isadora-fernanda/pigsave-esp8266/hardware/3d/tampa-com-dobradica/solidworks/Conjunto tampa.SLDASM

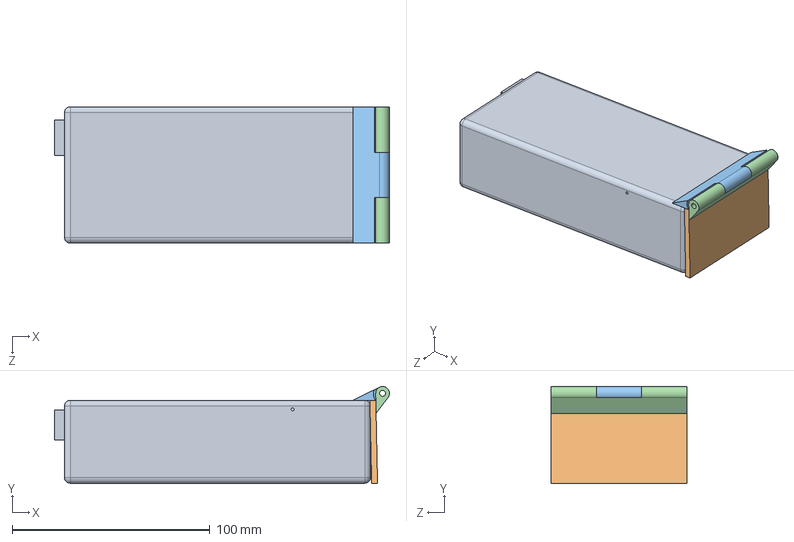
[picture p8: CAD file, 2026-10-20]
hardware/3d/tampa-com-dobradica/solidworks/Conjunto tampa.SLDASM
169.5 x 49.1 x 69.0 mm
Base cinta teste 2
LID
Hinge 1
Hinge 2
