isadora-fernanda/pigsave-esp8266/hardware/3d/involucro/solidworks/Conjunto REV03.SLDASM

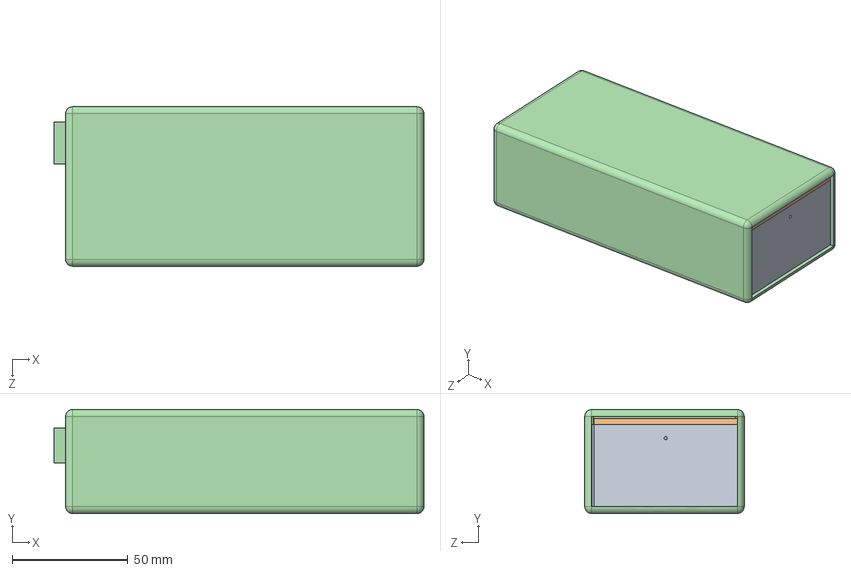
[picture p9: CAD file, 2026-10-20]
hardware/3d/involucro/solidworks/Conjunto REV03.SLDASM
160.0 x 45.0 x 69.0 mm
base bateria REV03
Tampa bateria REV03
Gaveta placa REV03
Base cinta REV03
