isadora-fernanda/pigsave-esp8266/hardware/3d/involucro/solidworks/Gaveta placa REV03.SLDPRT

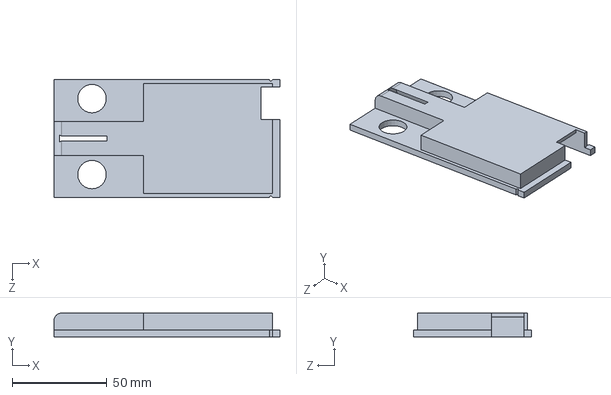
[picture p10: CAD file, 2026-10-20]
hardware/3d/involucro/solidworks/Gaveta placa REV03.SLDPRT
119.0 x 12.6 x 62.0 mm
