isadora-fernanda/pigsave-esp8266/hardware/3d/involucro/solidworks/Base cinta REV03.SLDPRT

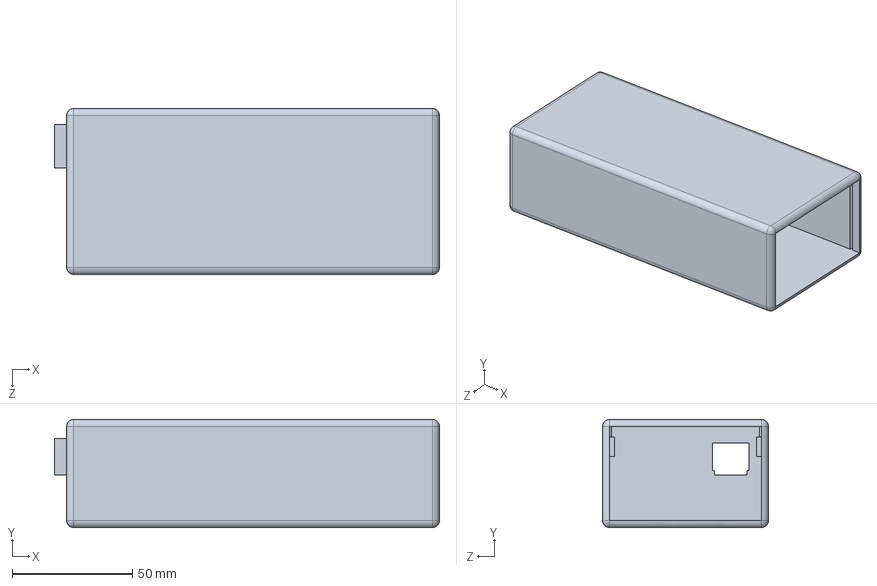
[picture p11: CAD file, 2026-10-20]
hardware/3d/involucro/solidworks/Base cinta REV03.SLDPRT
160.0 x 45.0 x 69.0 mm
