isadora-fernanda/pigsave-esp8266/hardware/3d/tampa-com-dobradica/solidworks/LID.SLDPRT

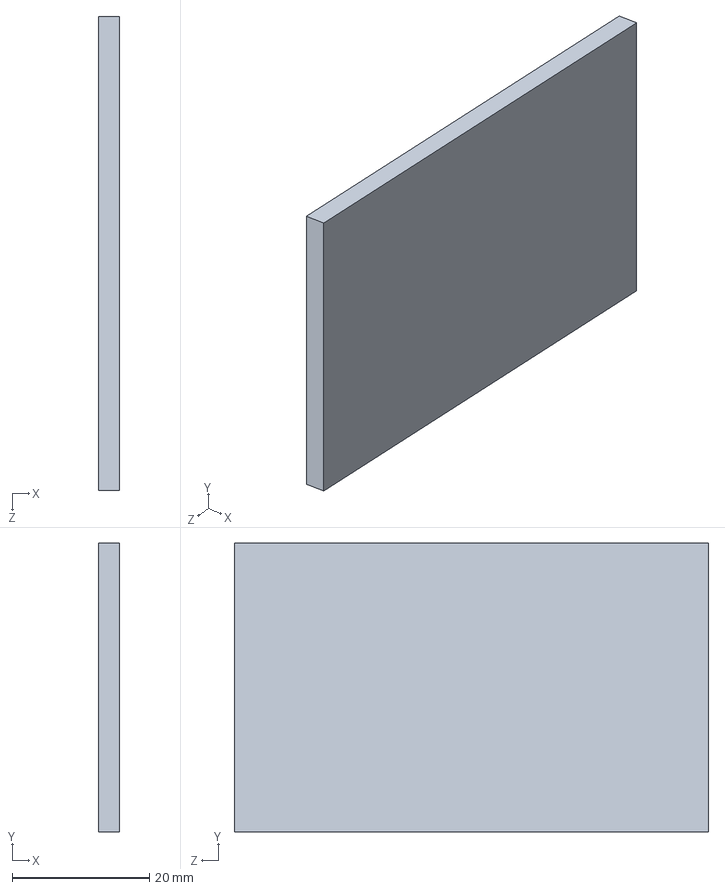
[picture p12: CAD file, 2026-10-20]
hardware/3d/tampa-com-dobradica/solidworks/LID.SLDPRT
3.00 x 42.0 x 69.0 mm
