isadora-fernanda/pigsave-esp8266/hardware/3d/involucro/solidworks/base bateria REV03.SLDPRT

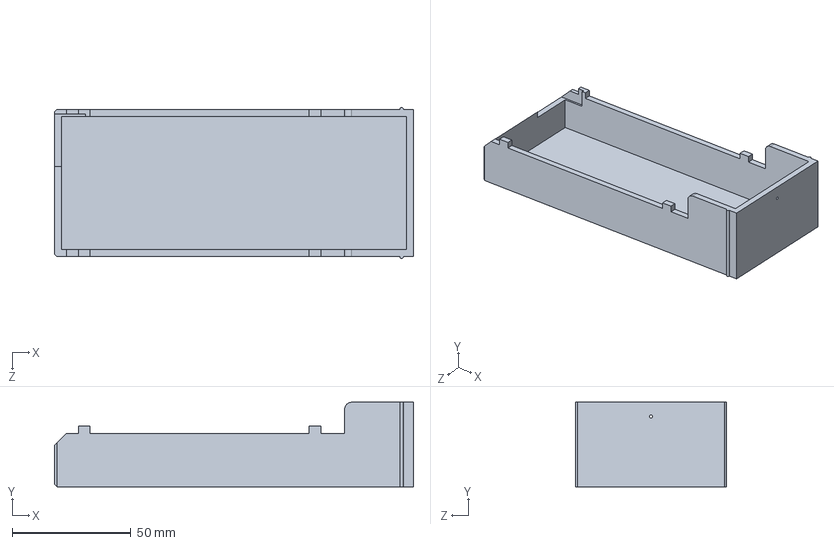
[picture p13: CAD file, 2026-10-20]
hardware/3d/involucro/solidworks/base bateria REV03.SLDPRT
151.0 x 35.6 x 63.5 mm
