isadora-fernanda/pigsave-esp8266/hardware/3d/tampa-com-dobradica/solidworks/Base cinta teste 2.SLDPRT

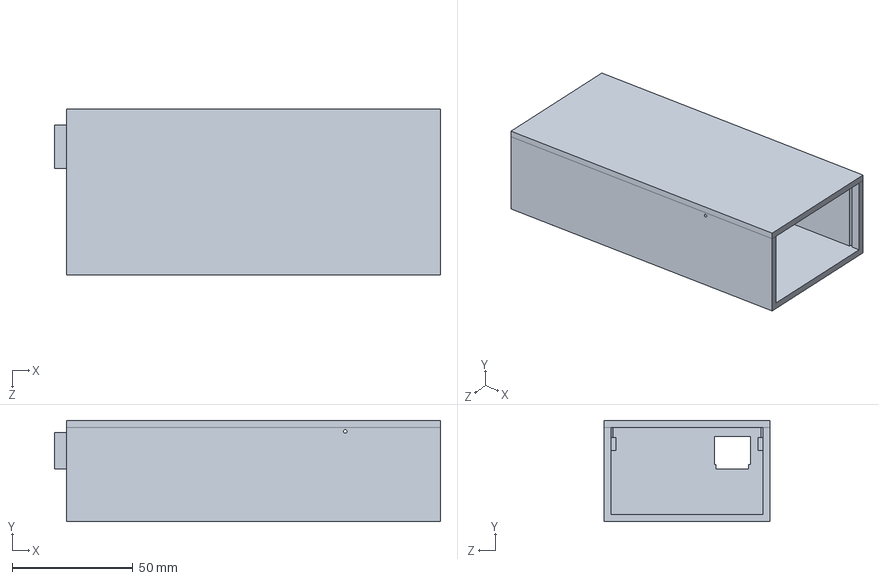
[picture p14: CAD file, 2026-10-20]
hardware/3d/tampa-com-dobradica/solidworks/Base cinta teste 2.SLDPRT
160.0 x 42.0 x 69.0 mm
