isadora-fernanda/pigsave-esp8266/hardware/3d/involucro/solidworks/Tampa bateria REV03.SLDPRT

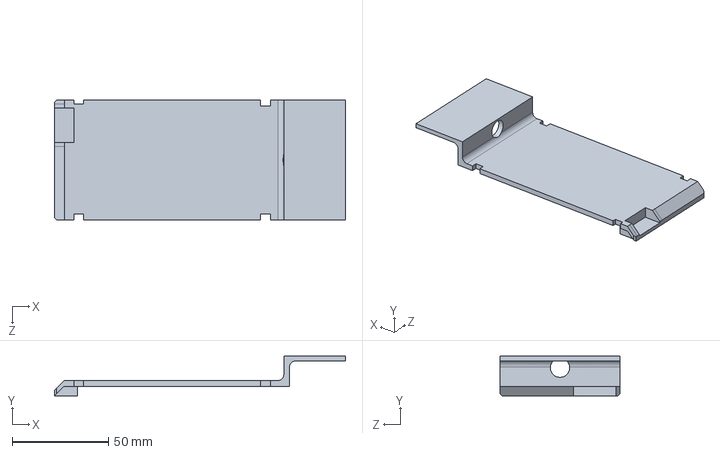
[picture p15: CAD file, 2026-10-20]
hardware/3d/involucro/solidworks/Tampa bateria REV03.SLDPRT
151.0 x 20.6 x 62.0 mm
