isadora-fernanda/pigsave-esp8266/hardware/3d/tampa-com-dobradica/solidworks/Hinge 2.SLDPRT

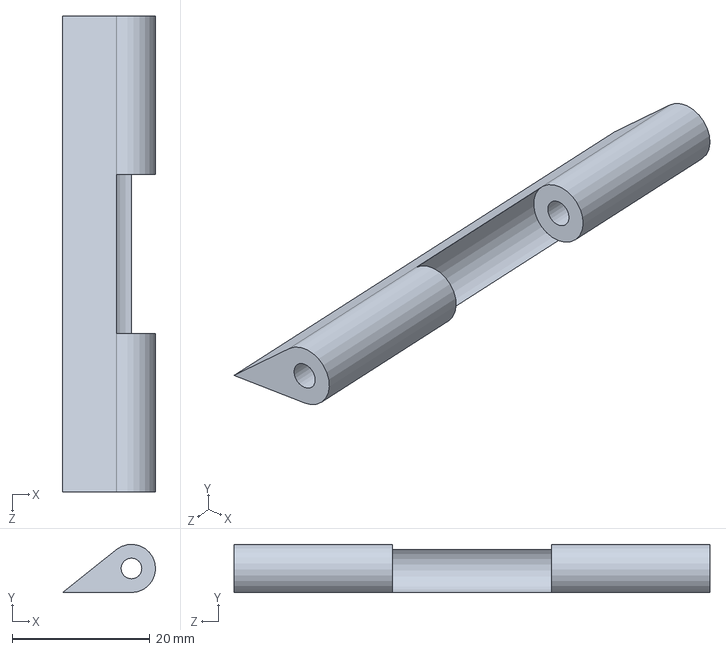
[picture p16: CAD file, 2026-10-20]
hardware/3d/tampa-com-dobradica/solidworks/Hinge 2.SLDPRT
13.5 x 6.99 x 69.0 mm
