isadora-fernanda/pigsave-esp8266/hardware/3d/tampa-com-dobradica/solidworks/Hinge 1.SLDPRT

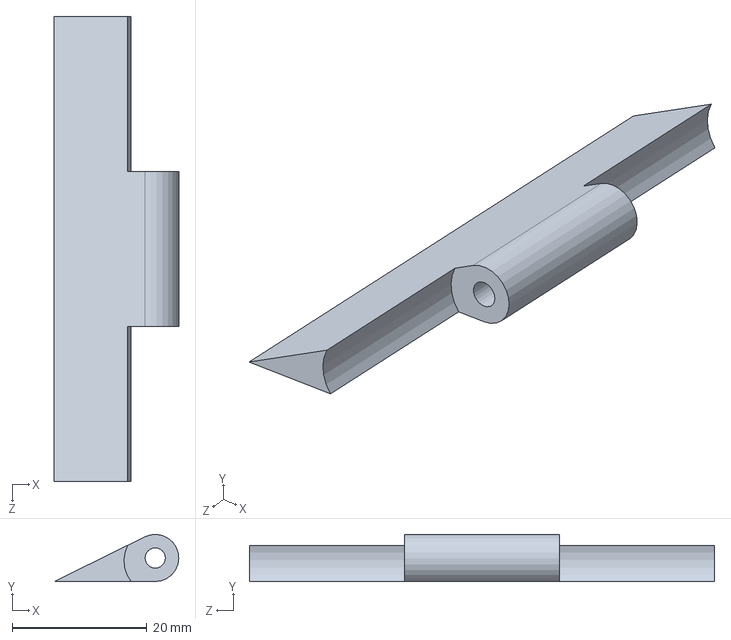
[picture p17: CAD file, 2026-10-20]
hardware/3d/tampa-com-dobradica/solidworks/Hinge 1.SLDPRT
18.5 x 6.99 x 69.0 mm
