isadora-fernanda/pigsave-esp8266/(list of files, cad)

Other CAD files:
hardware/3d/involucro/stl/Base cinta REV03.STL
hardware/3d/involucro/stl/Gaveta placa REV03.STL
hardware/3d/involucro/stl/Tampa bateria REV03.STL
hardware/3d/involucro/stl/base bateria REV03.STL
hardware/3d/tampa-com-dobradica/stl/Hinge 1.STL
hardware/3d/tampa-com-dobradica/stl/Hinge 2.STL
hardware/3d/tampa-com-dobradica/stl/LID.STL
