isadora-fernanda/pigsave-esp8266/firmware/include/config.h

#ifndef CONFIG_H
#define CONFIG_H

// Rede Wi-Fi do roteador da granja (usada só na versão com Wi-Fi)
#define WIFI_SSID     "NOME_DA_REDE"
#define WIFI_PASSWORD "SENHA_DA_REDE"

// Cada cinta tem um IP fixo e um nome, que aparecem no aplicativo
#define FINAL_DO_IP   173
#define NOME_CINTA    "9"

// Tempos padrão do ciclo dos motores, em milissegundos
#define TEMPO_LIGADO     10000
#define TEMPO_DESLIGADO  30000

#endif
