isadora-fernanda/pigsave-esp8266/(commit log)

2026-10-20 Adiciona firmware, invólucro 3D e documentação do PigSave
    Firmware ESP8266 (PlatformIO) com versões com e sem Wi-Fi, peças 3D em SolidWorks e STL, fotos e README.
    [Base cinta REV03.SLDPRT, Base cinta REV03.STL, Base cinta teste 2.SLDPRT, Conjunto REV03.SLDASM, Conjunto tampa.SLDASM, Gaveta placa REV03.SLDPRT, Gaveta placa REV03.STL, Hinge 1.SLDPRT]
2026-10-20 Adiciona recursos de sistemas embarcados ao README
